mabarnett0/EPROMburner/hardware/SDRAMPS_Schematic.png

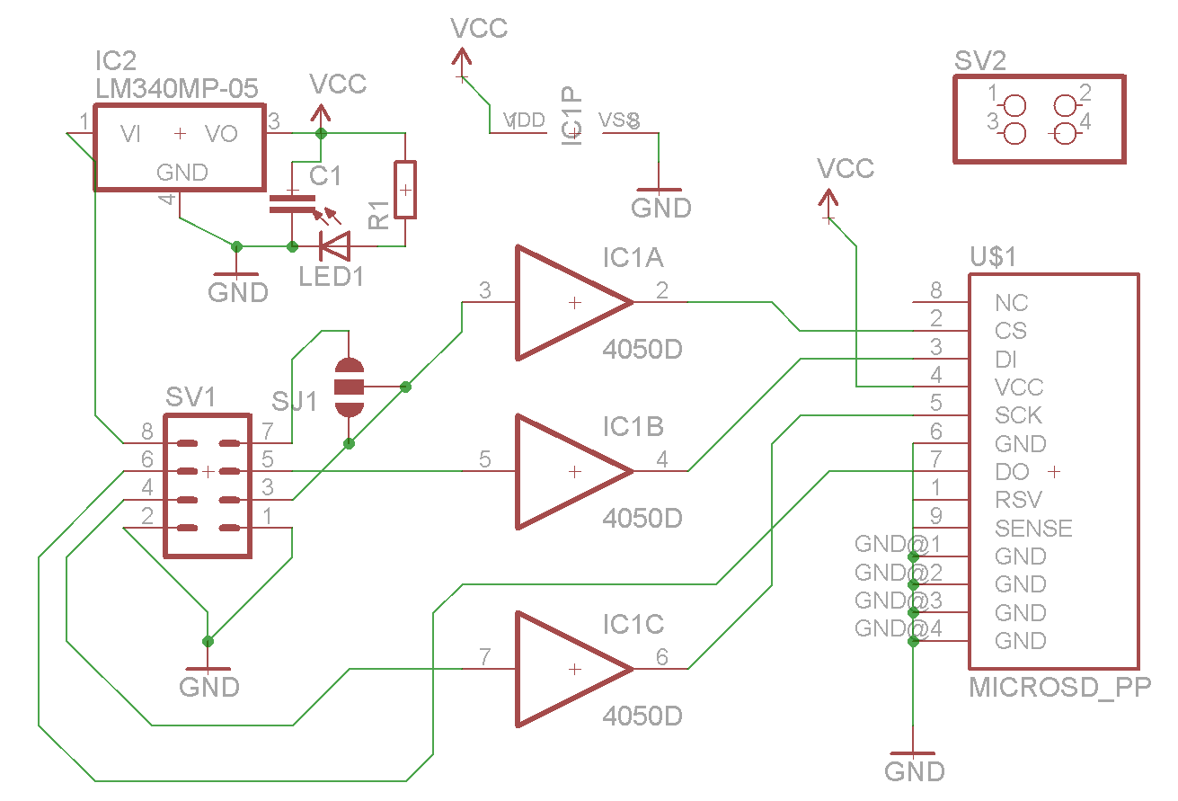
hardware/SDRAMPS_Schematic.png
