mabarnett0/EPROMburner/hardware/EPROMburner.pdf

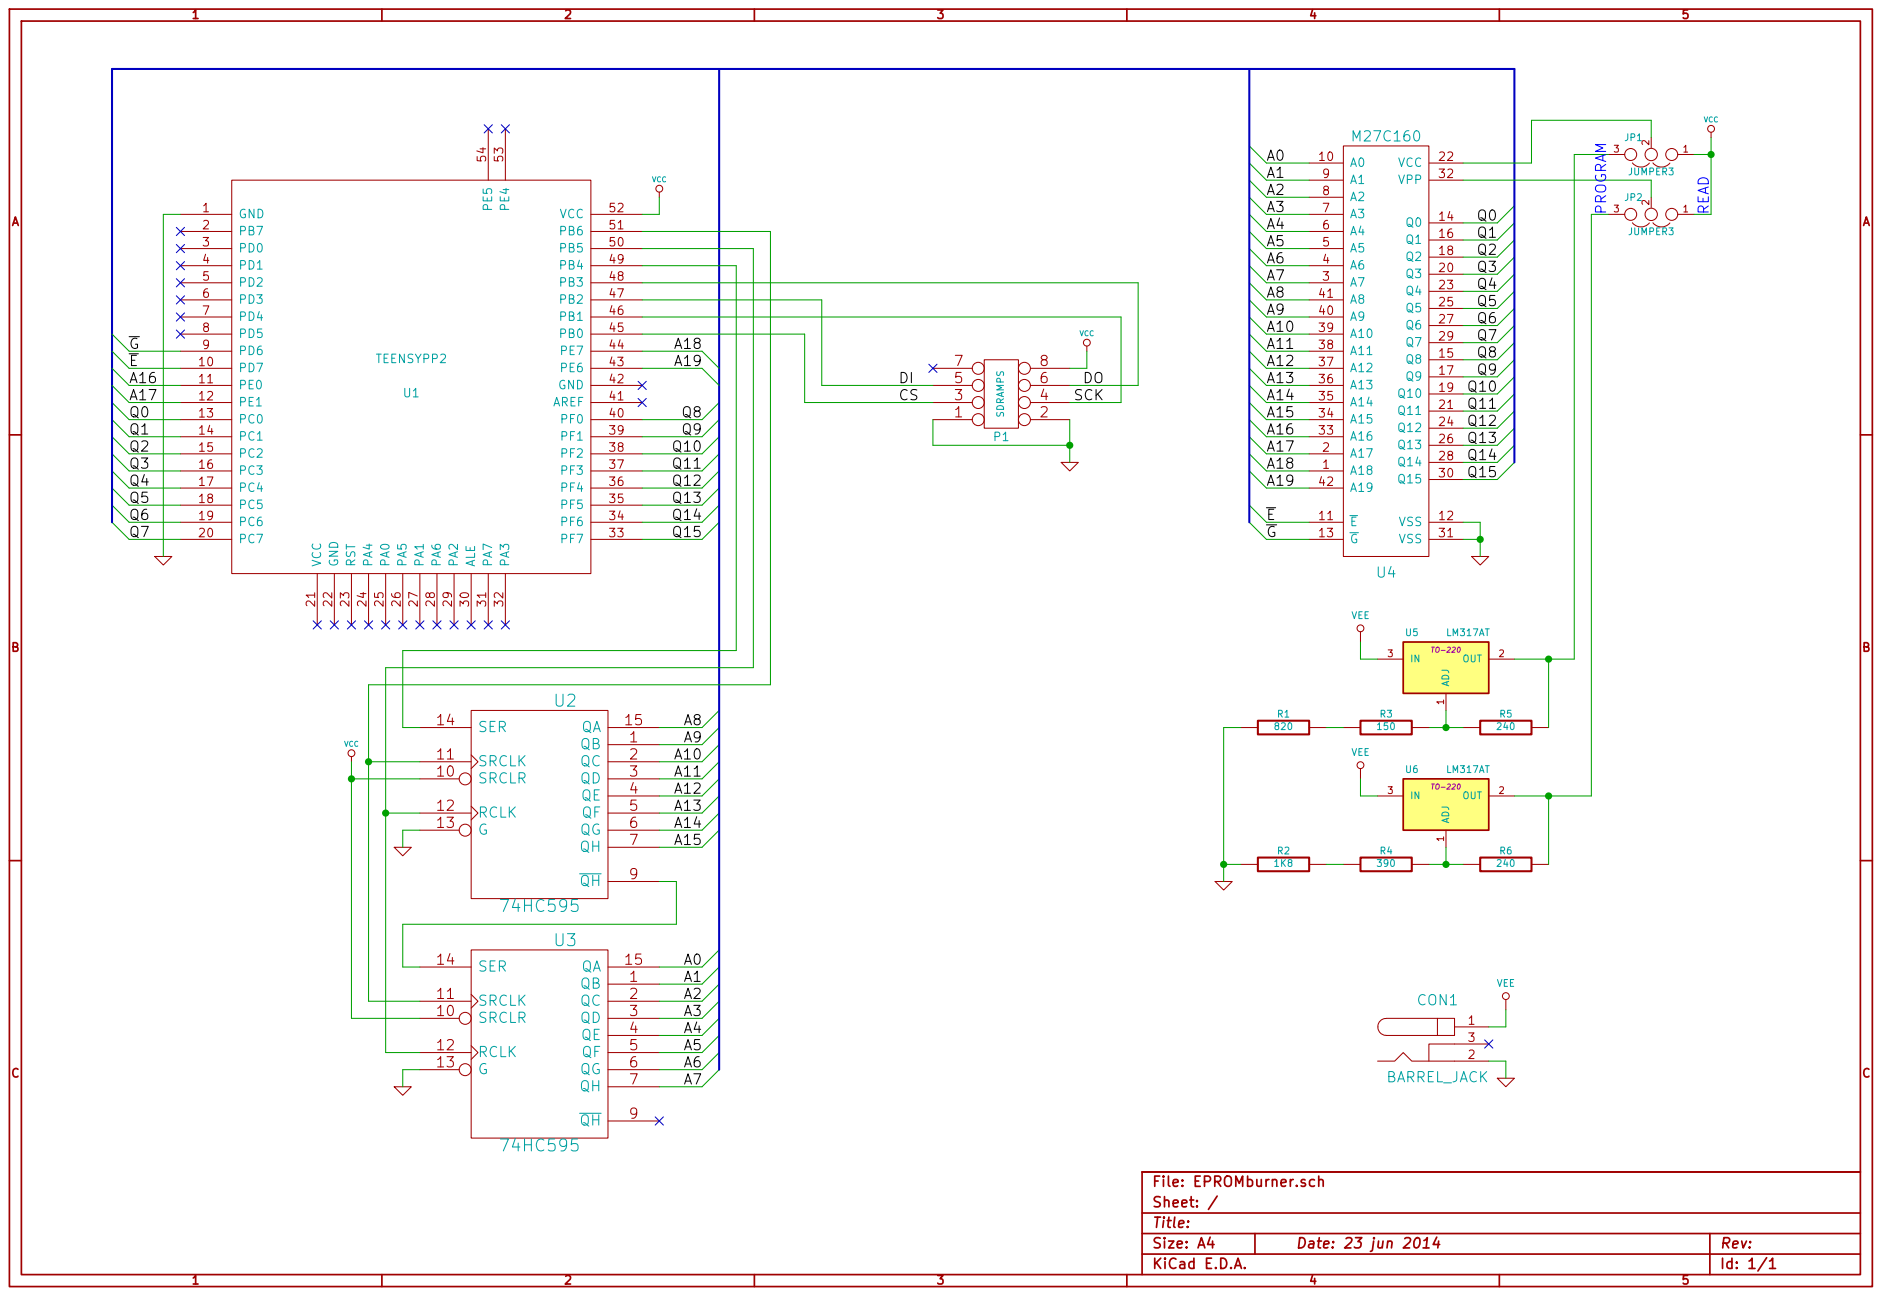
[picture p2: page 1]

Id: 1/1 Title: File: EPROMburner.sch
Sheet: /
