mabarnett0/EPROMburner/hardware/EPROMburner.sch

## KiCad design hardware/EPROMburner.sch (2014-06-23)

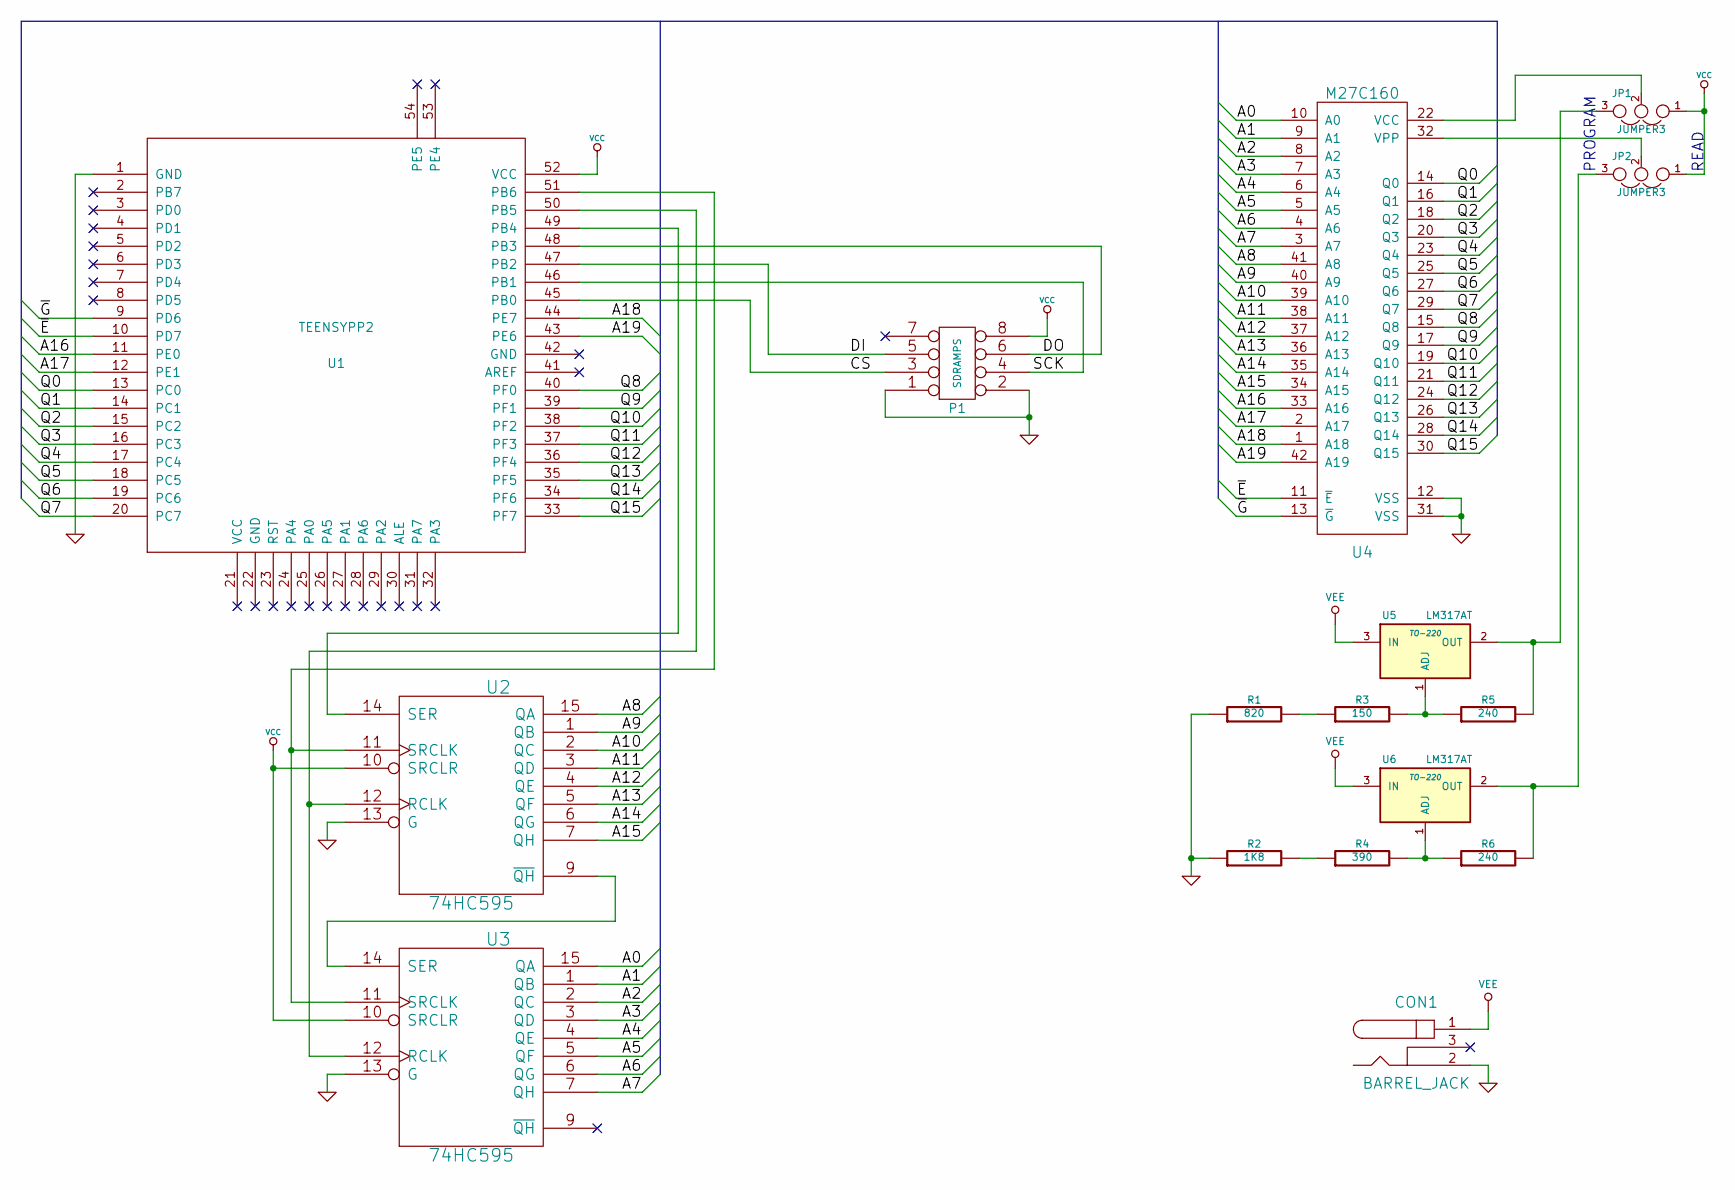
[picture p3: schematic EPROMburner.sch]

Parts:
CON1: BARREL_JACK
JP1, JP2: JUMPER3
P1: SDRAMPS
R1: 820
R2: 1K8
R3: 150
R4: 390
R5, R6: 240
U1: TEENSYPP2; MODULE
U2, U3: 74HC595
U4: M27C160
U5, U6: LM317AT; TO-220

Connections:
A0: U3.15 (QA), U4.10 (A0)
A1: U3.1 (QB), U4.9 (A1)
A2: U3.2 (QC), U4.8 (A2)
A3: U3.3 (QD), U4.7 (A3)
A4: U3.4 (QE), U4.6 (A4)
A5: U3.5 (QF), U4.5 (A5)
A6: U3.6 (QG), U4.4 (A6)
A7: U3.7 (QH), U4.3 (A7)
A8: U2.15 (QA), U4.41 (A8)
A9: U2.1 (QB), U4.40 (A9)
A10: U2.2 (QC), U4.39 (A10)
A11: U2.3 (QD), U4.38 (A11)
A12: U2.4 (QE), U4.37 (A12)
A13: U2.5 (QF), U4.36 (A13)
A14: U2.6 (QG), U4.35 (A14)
A15: U2.7 (QH), U4.34 (A15)
A16: U1.11 (PE0), U4.33 (A16)
A17: U1.12 (PE1), U4.2 (A17)
A18: U1.44 (PE7), U4.1 (A18)
A19: U1.43 (PE6), U4.42 (A19)
CS: P1.3, U1.45 (PB0)
DI: P1.5, U1.47 (PB2)
DO: P1.6, U1.48 (PB3)
GND: CON1.2, P1.1, P1.2, R1.1, R2.1, U1.1 (GND), U2.13 (G), U3.13 (G), U4.12 (VSS), U4.31 (VSS)
unnamed: JP1.2, U4.22 (VCC)
unnamed: JP1.3, R5.2, U5.2 (OUT)
unnamed: JP2.2, U4.32 (VPP)
unnamed: JP2.3, R6.2, U6.2 (OUT)
unnamed: R1.2, R3.1
unnamed: R2.2, R4.1
unnamed: R3.2, R5.1, U5.1 (ADJ)
unnamed: R4.2, R6.1, U6.1 (ADJ)
unnamed: U1.49 (PB4), U2.14 (SER)
unnamed: U1.50 (PB5), U2.12 (RCLK), U3.12 (RCLK)
unnamed: U1.51 (PB6), U2.11 (SRCLK), U3.11 (SRCLK)
unnamed: U2.9 (~QH), U3.14 (SER)
Q0: U1.13 (PC0), U4.14 (Q0)
Q1: U1.14 (PC1), U4.16 (Q1)
Q2: U1.15 (PC2), U4.18 (Q2)
Q3: U1.16 (PC3), U4.20 (Q3)
Q4: U1.17 (PC4), U4.23 (Q4)
Q5: U1.18 (PC5), U4.25 (Q5)
Q6: U1.19 (PC6), U4.27 (Q6)
Q7: U1.20 (PC7), U4.29 (Q7)
Q8: U1.40 (PF0), U4.15 (Q8)
Q9: U1.39 (PF1), U4.17 (Q9)
Q10: U1.38 (PF2), U4.19 (Q10)
Q11: U1.37 (PF3), U4.21 (Q11)
Q12: U1.36 (PF4), U4.24 (Q12)
Q13: U1.35 (PF5), U4.26 (Q13)
Q14: U1.34 (PF6), U4.28 (Q14)
Q15: U1.33 (PF7), U4.30 (Q15)
SCK: P1.4, U1.46 (PB1)
VCC: JP1.1, JP2.1, P1.8, U1.52 (VCC), U2.10 (SRCLR), U3.10 (SRCLR)
VEE: CON1.1, U5.3 (IN), U6.3 (IN)
~E: U1.10 (PD7), U4.11 (~E)
~G: U1.9 (PD6), U4.13 (~G)

Notes on the sheet:
PROGRAM
READ
